mole99/waferspace-main-pcb/README.md

# wafer.space Main PCB

This repository holds the main PCB for [gf180mcu FABulous FPGA](https://github.com/mole99/gf180mcu-fabulous-fpga).

<p align="center">
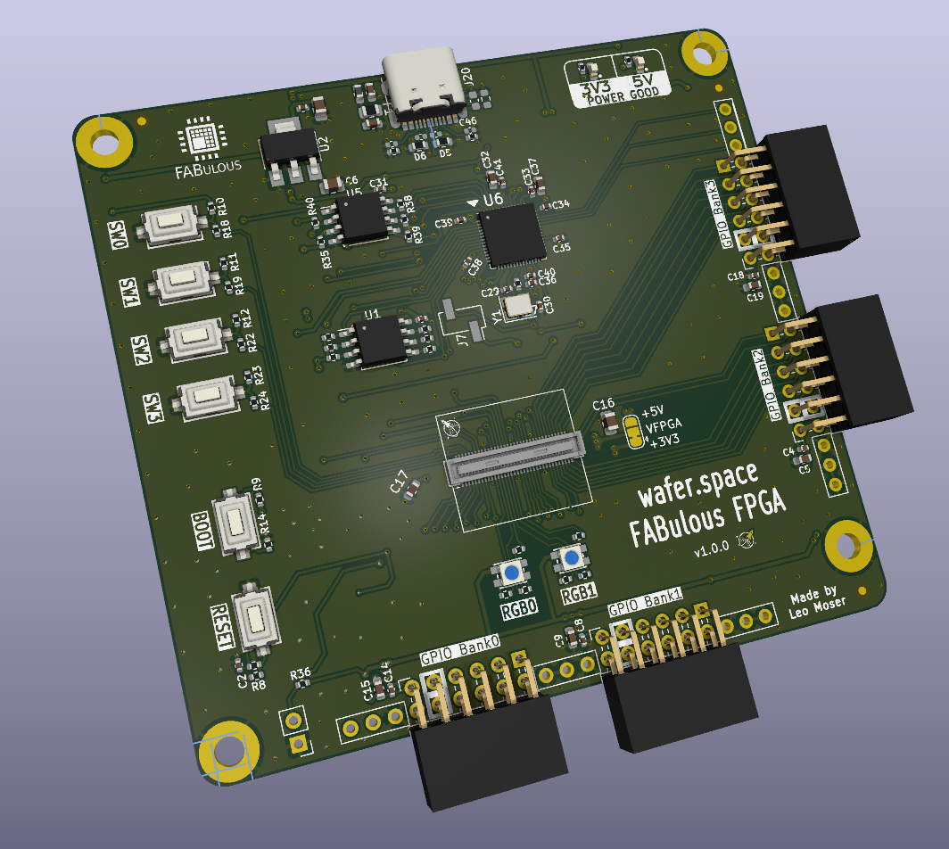
[picture p1: img/waferspace-main-pcb.png]
PCB

</p>

It is based on the [TinyTapeout Demo Board](https://github.com/TinyTapeout/tt-demo-pcb). Thanks a lot!

The PCB was designed with KiCad version 10.0.

Check out the project in your browser using KiCanvas: [wafer.space Main PCB](https://kicanvas.org/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)

# License

The PCB is licensed under the Apache 2 License
