mole99/waferspace-main-pcb/pad_assignment.md

# 1x1 CoB PCB to Chip

# North

| CoB | FPGA |
|-----|---|
|pad0  | clk_pad|
|pad1  | rst_n_pad|
|pad2  | fpga[0].pad|
|pad3  | fpga[1].pad|
|pad4  | fpga[2].pad|
|pad5  | fpga[3].pad|
|pad6  | fpga[4].pad|
|pad7  | fpga[5].pad|
|GND | VSS|
|pad9  | fpga[6].pad|
|pad10 | fpga[7].pad|
|pad11 | fpga[8].pad|
|pad12 | fpga[9].pad|
|pad13 | fpga[10].pad|
|pad14 | fpga[11].pad|
|pad15 | fpga[12].pad|
|pad16 | fpga[13].pad|

# West

| CoB | FPGA |
|-----|---|
|VDDIO_0 | VDD|
|GND | VSS|
|pad19 | fpga[14].pad|
|pad20 | fpga[15].pad|
|pad21 | fpga[16].pad|
|pad22 | fpga[17].pad|
|pad23 | fpga[18].pad|
|pad24 | fpga[19].pad|
|PWRAUX_0 | VDD|
|GND | VSS|
|pad27 | fpga[20].pad|
|pad28 | fpga[21].pad|
|pad29 | fpga[22].pad|
|pad30 | fpga[23].pad|
|pad31 | fpga[24].pad|
|pad32 | fpga[25].pad|
|GND | VSS|
|VDDCORE_0 | VDD|
|GND | VSS|
|VDDIO_1 | VDD|

# South

| CoB | FPGA |
|-----|---|
|pad37 | fpga[26].pad|
|pad38 | fpga[27].pad|
|pad39 | fpga[28].pad|
|pad40 | fpga[29].pad|
|pad41 | fpga[30].pad|
|pad42 | fpga[31].pad|
|pad43 | fpga[32].pad|
|pad44 | fpga[33].pad|
|GND | VSS|
|pad46 | fpga[34].pad|
|pad47 | fpga[35].pad|
|pad48 | fpga[36].pad|
|pad49 | fpga[37].pad|
|pad50 | fpga[38].pad|
|pad51 | fpga[39].pad|
|pad52 | fpga[40].pad|
|pad53 | fpga[41].pad|

# West

| CoB | FPGA |
|-----|---|
|pad54 | fpga[42].pad|
|pad55 | fpga[43].pad|
|GND | VSS|
|VDDIO_2 | VDD|
|pad58 | fpga[44].pad|
|pad59 | fpga[45].pad|
|pad60 | fpga[46].pad|
|pad61 | fpga[47].pad|
|GND | VSS|
|PWRAUX_1 | VDD|
|pad64 | fpga_sclk_pad|
|pad65 | fpga_cs_n_pad|
|pad66 | fpga_mosi_pad|
|pad67 | fpga_miso_pad|
|pad68 | fpga_mode_pad|
|pad69 | fpga_busy_pad|
|GND | VSS|
|VDDCORE_1 | VDD|
|GND | VSS|
|VDDIO_3 | VDD|
