mole99/waferspace-main-pcb/3dmodels/DF40C-70DS--3DModel-STEP-1.STEP

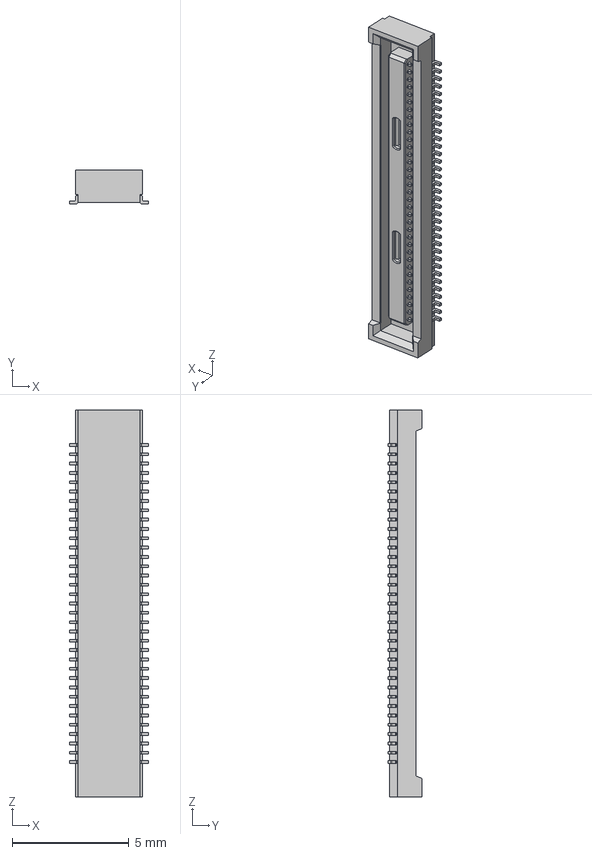
[picture p2: CAD file, 2026-06-12]
3dmodels/DF40C-70DS--3DModel-STEP-1.STEP
3.38 x 1.45 x 16.6 mm
