mole99/waferspace-main-pcb/waferspace-main-pcb.kicad_sch

## KiCad design waferspace-main-pcb.kicad_sch (2026-06-12)

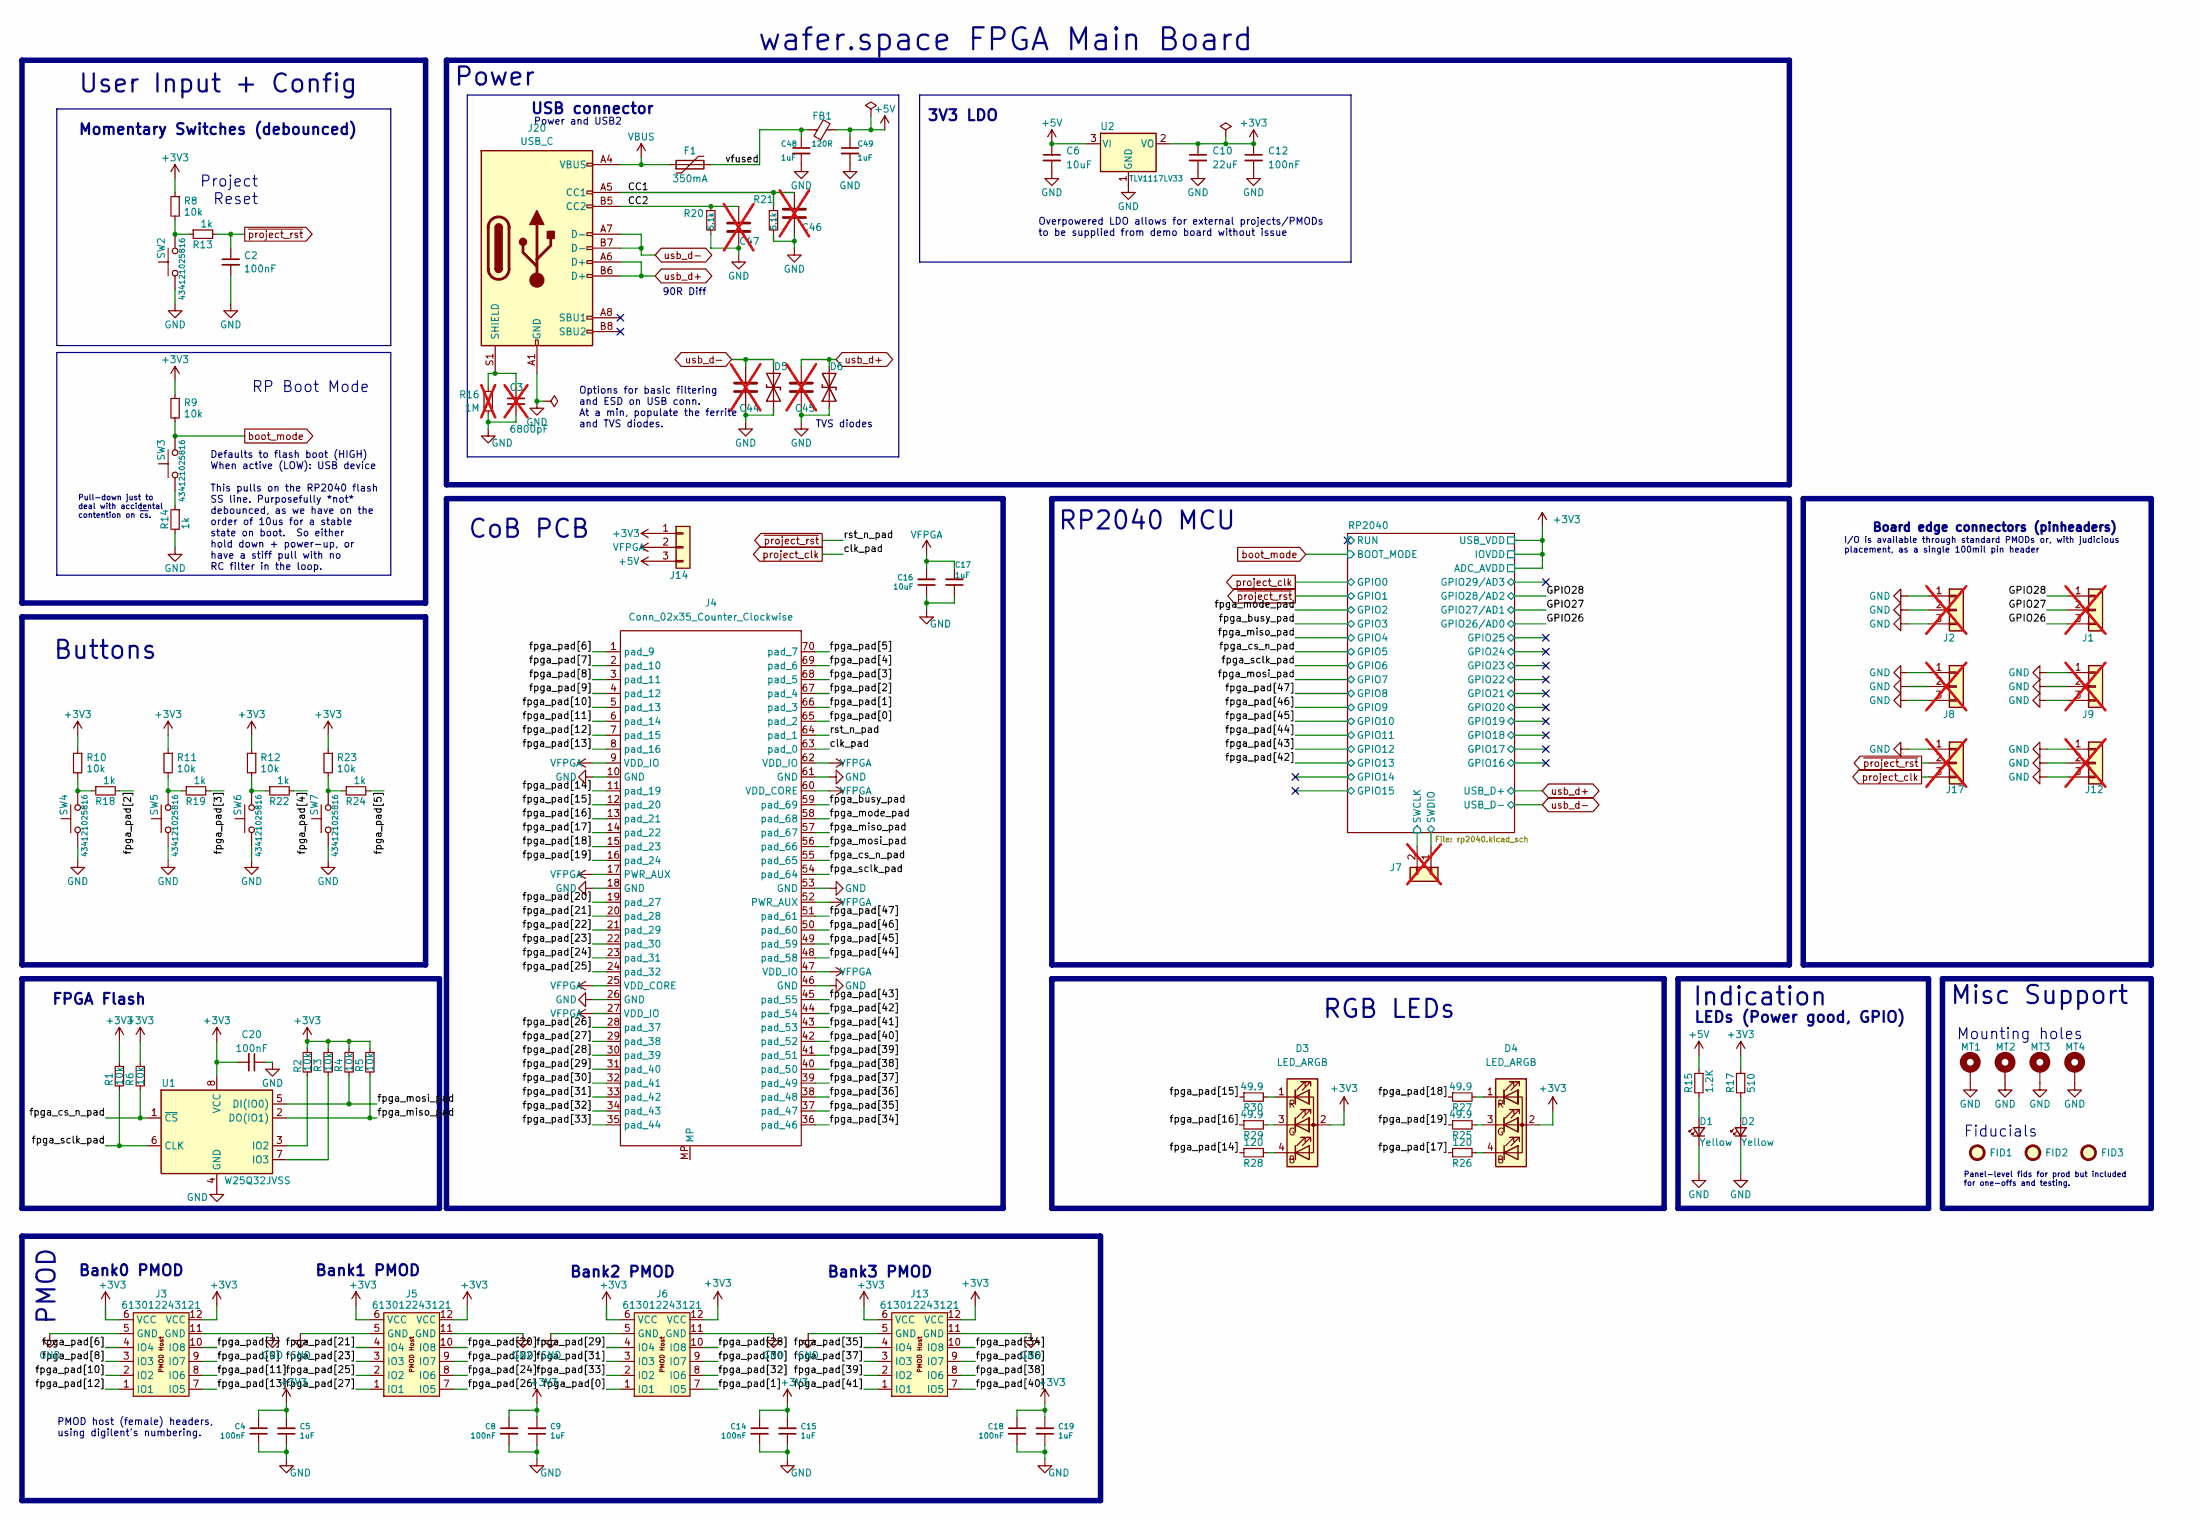
[picture p4: schematic waferspace-main-pcb.kicad_sch]

Parts:
C2, C4, C8, C12, C14, C18, C20: 100nF; C_0402_1005Metric; MPN CL05A104KA5NNNC; LCSC C1525
C3: 6800pF; C_0603_1608Metric; not fitted
C5, C9, C15, C17, C19, C48, C49: 1uF; C_0603_1608Metric; MPN CL10A105KA8NNNC; LCSC C15849
C6, C16: 10uF; C_0805_2012Metric; MPN GRM21BR71C106KE51L; LCSC C15850
C10: 22uF; C_0805_2012Metric; MPN CL21A226KOQNNNG; LCSC C45783
C44, C45, C46, C47: C_33p_0402_50V; C_0402_1005Metric; MPN CC0402JRNPO9BN330; DigikeyPN 311-1020-1-ND; not fitted
D1, D2: Yellow; LED_0603_1608Metric; MPN CSL1901YW1; LCSC C2290
D3, D4: LED_ARGB; LED-SMD_4P-L3.2-W2.8-LS3.5-XL-3528RGBW-HM5; LCSC C2843813
D5, D6: TVS; R_0603_1608Metric; MPN 0603ESDA-AEC1; DigikeyPN 283-0603ESDA-AEC1CT-ND
F1: 350mA; Fuse_0805_2012Metric; MPN 0ZCK0035FF2G; LCSC C1884490
FB1: 120R; L_0603_1608Metric; MPN BLM18PG121SN1D; DigikeyPN 283-MFBM1V1608-121-RCT-ND
FID1, FID2, FID3: Fiducial; Fiducial_1mm_Mask2mm
J1, J2, J8, J9, J12, J17: Conn_01x03; PinHeader_1x03_P2.54mm_Vertical; not fitted
J3, J5, J6, J13: 613012243121; PinSocket_2x06_P2.54mm_PMODHost1A; MPN PPTC062LJBN-RC; LCSC C22373932
J4: Conn_02x35_Counter_Clockwise; CONN-SMD_70P-P0.40_HC-PBB40C-70DS-0.4V-3.0-02; LCSC C19089292
J7: Conn_01x02; PinHeader_1x02_P2.54mm_Vertical_SMD_Pin1Right; MPN 10129380-902001BLF; not fitted
J14: Conn_01x03; SolderJumper-3_P1.3mm_Bridged12_RoundedPad1.0x1.5mm
J20: USB_C; USB_C_Receptacle_HRO_TYPE-C-31-M-12; MPN USB-TYPE-C-019; DigikeyPN USB4105-GF-A-120
MT1, MT2, MT3, MT4: MountingHole_Pad; MountingHole_3.2mm_M3_Pad; MPN DNP
R1, R2, R3, R4, R5, R6, R8, R9, R10, R11, R12, R23: 10k; R_0402_1005Metric; MPN RC0402FR-0710KL; LCSC C25744
R13, R14, R18, R19, R22, R24: 1k; R_0402_1005Metric; MPN CR0402-FX-1001GLF; LCSC C11702
R15: 1.2K; R_0402_1005Metric; MPN RC0402FR-071K2L; LCSC C138040
R16: 1M; R_0603_1608Metric; LCSC C858907; not fitted
R17: 510; R_0402_1005Metric; MPN RC0402FR-07510RL; LCSC C25123
R20, R21: 5.1k; R_0402_1005Metric; MPN AC0402FR-135K1L; LCSC C138073
R25, R27, R29, R30: 49.9; R_0402_1005Metric; MPN RC0402FR-071K2L; LCSC C25120
R26, R28: 120; R_0402_1005Metric; MPN RC0402FR-07510RL; LCSC C25079
SW2, SW3, SW4, SW5, SW6, SW7: 434121025816; MPN 434121025816; LCSC C329185
U1: W25Q32JVSS; SOIC-8_5.23x5.23mm_P1.27mm; MPN W25Q32JVSSIQ; DigikeyPN W25Q32JVSSIQ-ND
U2: TLV1117LV33; SOT-223-3_TabPin2; MPN TLV1117LV33DCYR; LCSC C15578

Connections:
+3V3: C4.1, C5.2, C8.1, C9.2, C10.1, C12.1, C14.1, C15.2, C18.1, C19.2, C20.2, D3.2 (A), D4.2 (A), J3.6 (VCC), J3.12 (VCC), J5.6 (VCC), J5.12 (VCC), J6.6 (VCC), J6.12 (VCC), J13.6 (VCC), J13.12 (VCC), J14.1, R1.1, R2.1, R3.1, R4.1, R5.1, R6.1, R8.1, R9.1, R10.1, R11.1, R12.1, R17.1, R23.1, U1.8 (VCC), U2.2 (VO)
+5V: C6.1, C49.1, FB1.2, J14.3, R15.1, U2.3 (VI)
CC1: C46.1, J20.A5 (CC1), R21.1
CC2: C47.1, J20.B5 (CC2), R20.1
GND: C2.2, C3.2, C4.2, C5.1, C6.2, C8.2, C9.1, C10.2, C12.2, C14.2, C15.1, C16.1, C17.1, C18.2, C19.1, C20.1, C44.2, C45.2, C46.2, C47.2, C48.2, C49.2, D1.1 (K), D2.1 (K), D5.1 (A1), D6.1 (A1), J2.1, J2.2, J2.3, J3.5 (GND), J3.11 (GND), J4.10 (GND), J4.18 (GND), J4.26 (GND), J4.46 (GND), J4.53 (GND), J4.61 (GND), J5.5 (GND), J5.11 (GND), J6.5 (GND), J6.11 (GND), J8.1, J8.2, J8.3, J9.1, J9.2, J9.3, J12.1, J12.2, J12.3, J13.5 (GND), J13.11 (GND), J17.1, J20.A1 (GND), J20.A12 (GND), J20.B1 (GND), J20.B12 (GND), MT1.1, MT2.1, MT3.1, MT4.1, R14.2, R16.2, R20.2, R21.2, SW2.1, SW4.1, SW5.1, SW6.1, SW7.1, U1.4 (GND), U2.1 (GND)
GPIO26: J1.3
GPIO27: J1.2
GPIO28: J1.1
unnamed: C3.1, J20.S1 (SHIELD), R16.1
unnamed: D1.2 (A), R15.2
unnamed: D2.2 (A), R17.2
unnamed: D3.1 (RK), R30.2
unnamed: D3.3 (GK), R29.2
unnamed: D3.4 (BK), R28.2
unnamed: D4.1 (RK), R27.2
unnamed: D4.3 (GK), R25.2
unnamed: D4.4 (BK), R26.2
unnamed: R2.2, U1.3 (IO2)
unnamed: R3.2, U1.7 (IO3)
unnamed: R10.2, R18.1, SW4.2
unnamed: R11.2, R19.1, SW5.2
unnamed: R12.2, R22.1, SW6.2
unnamed: R8.2, R13.1, SW2.2
unnamed: R14.1, SW3.1
unnamed: R23.2, R24.1, SW7.2
SWCLK: J7.2
SWDIO: J7.1
VBUS: F1.1, J20.A4 (VBUS), J20.A9 (VBUS), J20.B4 (VBUS), J20.B9 (VBUS)
VFPGA: C16.2, C17.2, J4.9 (VDD_IO), J4.17 (PWR_AUX), J4.25 (VDD_CORE), J4.27 (VDD_IO), J4.47 (VDD_IO), J4.52 (PWR_AUX), J4.60 (VDD_CORE), J4.62 (VDD_IO), J14.2
boot_mode: R9.2, SW3.2
fpga_busy_pad: J4.59 (pad_69)
fpga_cs_n_pad: J4.55 (pad_65), R6.2, U1.1 (~CS)
fpga_miso_pad: J4.57 (pad_67), R5.2, U1.2 (DO(IO1))
fpga_mode_pad: J4.58 (pad_68)
fpga_mosi_pad: J4.56 (pad_66), R4.2, U1.5 (DI(IO0))
fpga_pad[0]: J4.65 (pad_2), J6.1 (IO1)
fpga_pad[1]: J4.66 (pad_3), J6.7 (IO5)
fpga_pad[2]: J4.67 (pad_4), R18.2
fpga_pad[3]: J4.68 (pad_5), R19.2
fpga_pad[4]: J4.69 (pad_6), R22.2
fpga_pad[5]: J4.70 (pad_7), R24.2
fpga_pad[6]: J3.4 (IO4), J4.1 (pad_9)
fpga_pad[7]: J3.10 (IO8), J4.2 (pad_10)
fpga_pad[8]: J3.3 (IO3), J4.3 (pad_11)
fpga_pad[9]: J3.9 (IO7), J4.4 (pad_12)
fpga_pad[10]: J3.2 (IO2), J4.5 (pad_13)
fpga_pad[11]: J3.8 (IO6), J4.6 (pad_14)
fpga_pad[12]: J3.1 (IO1), J4.7 (pad_15)
fpga_pad[13]: J3.7 (IO5), J4.8 (pad_16)
fpga_pad[14]: J4.11 (pad_19), R28.1
fpga_pad[15]: J4.12 (pad_20), R30.1
fpga_pad[16]: J4.13 (pad_21), R29.1
fpga_pad[17]: J4.14 (pad_22), R26.1
fpga_pad[18]: J4.15 (pad_23), R27.1
fpga_pad[19]: J4.16 (pad_24), R25.1
fpga_pad[20]: J4.19 (pad_27), J5.10 (IO8)
fpga_pad[21]: J4.20 (pad_28), J5.4 (IO4)
fpga_pad[22]: J4.21 (pad_29), J5.9 (IO7)
fpga_pad[23]: J4.22 (pad_30), J5.3 (IO3)
fpga_pad[24]: J4.23 (pad_31), J5.8 (IO6)
fpga_pad[25]: J4.24 (pad_32), J5.2 (IO2)
fpga_pad[26]: J4.28 (pad_37), J5.7 (IO5)
fpga_pad[27]: J4.29 (pad_38), J5.1 (IO1)
fpga_pad[28]: J4.30 (pad_39), J6.10 (IO8)
fpga_pad[29]: J4.31 (pad_40), J6.4 (IO4)
fpga_pad[30]: J4.32 (pad_41), J6.9 (IO7)
fpga_pad[31]: J4.33 (pad_42), J6.3 (IO3)
fpga_pad[32]: J4.34 (pad_43), J6.8 (IO6)
fpga_pad[33]: J4.35 (pad_44), J6.2 (IO2)
fpga_pad[34]: J4.36 (pad_46), J13.10 (IO8)
fpga_pad[35]: J4.37 (pad_47), J13.4 (IO4)
fpga_pad[36]: J4.38 (pad_48), J13.9 (IO7)
fpga_pad[37]: J4.39 (pad_49), J13.3 (IO3)
fpga_pad[38]: J4.40 (pad_50), J13.8 (IO6)
fpga_pad[39]: J4.41 (pad_51), J13.2 (IO2)
fpga_pad[40]: J4.42 (pad_52), J13.7 (IO5)
fpga_pad[41]: J4.43 (pad_53), J13.1 (IO1)
fpga_pad[42]: J4.44 (pad_54)
fpga_pad[43]: J4.45 (pad_55)
fpga_pad[44]: J4.48 (pad_58)
fpga_pad[45]: J4.49 (pad_59)
fpga_pad[46]: J4.50 (pad_60)
fpga_pad[47]: J4.51 (pad_61)
fpga_sclk_pad: J4.54 (pad_64), R1.2, U1.6 (CLK)
project_clk: J4.63 (pad_0), J17.3
usb_d+: C45.1, D6.2 (A2), J20.A6 (D+), J20.B6 (D+)
usb_d-: C44.1, D5.2 (A2), J20.A7 (D-), J20.B7 (D-)
vfused: C48.1, F1.2, FB1.1
~project_rst: C2.1, J4.64 (pad_1), J17.2, R13.2

Notes on the sheet:
LEDs (Power good, GPIO)
Panel-level fids for prod but included for one-offs and testing.
Options for basic filtering and ESD on USB conn. At a min, populate the ferrite and TVS diodes.
User Input + Config
Bank1 PMOD
Overpowered LDO allows for external projects/PMODs to be supplied from demo board without issue
FPGA Flash
Project Reset
USB connector
Bank0 PMOD
PMOD
Misc Support
Momentary Switches (debounced)
Board edge connectors (pinheaders)
Bank3 PMOD
Bank2 PMOD
I/O is available through standard PMODs or, with judicious placement, as a single 100mil pin header
3V3 LDO
Pull-down just to deal with accidental contention on ~{cs}.
Mounting holes
Power
90R Diff
Fiducials
Defaults to flash boot (HIGH) When active (LOW): USB device This pulls on the RP2040 flash SS line. Purposefully *not* debounced, as we have on the order of 10us for a stable state on boot. So either hold down + power-up, or have a stiff pull with no RC filter in the loop.
wafer.space FPGA Main Board
CoB PCB
RP2040 MCU
Indication
Power and USB2
PMOD host (female) headers, using digilent's numbering.
Buttons
RP Boot Mode
RGB LEDs
TVS diodes
