mole99/waferspace-main-pcb/(commit log)

2026-06-12 Add waferspace Main PCB
    [DF40C-70DS--3DModel-STEP-1.STEP, greyhound-main-pcb.kicad_pcb, greyhound-main-pcb.kicad_sch, rp2040.kicad_sch, waferspace-main-pcb.kicad_pcb, waferspace-main-pcb.kicad_sch]
2026-06-12 Fix RGB LEDs
    [waferspace-main-pcb.kicad_pcb, waferspace-main-pcb.kicad_sch]
