mole99/waferspace-main-pcb/(notices)

Notices in the files:
rp2040.kicad_sch:
(C) 2023, 2024 Pat Deegan
waferspace-main-pcb.kicad_sch:
(C) 2025 Pat Deegan
(C) 2026 Leo Moser
